nvairob2/rc_tracked_vehicle/doc/DIALOG.md

# История диалога и инженерный журнал

Проект: гусеничная платформа 10 кг (`rc_tracked_vehicle`)  
Участники: владелец проекта + AI-ассистент (Cursor / Composer)  
Формат: общий контекст для работы с разных устройств.

---

## 2026-07-24 — Сессия 1: аудит схемы, прошивок, коррекции скорости, R_IS/L_IS

### Запрос пользователя

Платформа на отладочном стенде вверх тормашками, электроника на breadboard.

- Питание моторов: 3S LiPo  
- Питание логики: UBEC 8А (12А)  
- Драйверы: BTS7960B по одному на мотор  
- Контроллер моторов: STM32F411CEU6 Black Pill  
- Общий контроллер: ESP32-S3-N16R8  

Задачи:

1. Изучить `doc/` и `schema/`
2. Изучить прошивки STM32 и ESP32
3. Разобрать корректность коррекции скорости по бортам
4. Задействовать `R_IS` / `L_IS`
5. Позже: перенос коммутации с breadboard на макетку 60×80 мм (22×27 отверстий, шаг 2.54)
6. Вести весь диалог в Markdown

---

### 1. Что есть в репозитории

| Путь | Содержание |
| :--- | :--- |
| `schema/commutation.md` | Актуальная (по факту кода) карта ESP32↔STM32 UART и ШИМ→BTS7960 |
| `schema/wire_connections.md` | Желаемая карта с аппаратными энкодерами TIM4/TIM5 — **конфликтует** с UART на PB6/PB7 |
| `sources/ESP32/vehicle_controller/` | Wi-Fi AP + веб-пульт → UART `Move,Turn\n` |
| `sources/STM32/motor_controller/` | Боевая прошивка: **open-loop**, без энкодеров |
| `sources/STM32/test_2_motors_rotation/` | Тест с «автопилотом» синхронизации бортов |
| `sources/STM32/test_1_motor_rotation/` | Аппаратный энкодер TIM5 на PA0/PA1 |
| `doc/10KG Tank chassisTutorial/` | Моторы JGB37-520, pinout энкодера, PDF параметров шасси |
| `doc/DOC028417869.pdf` | Крупный PDF (в основном сканы/картинки) |

Моторы: JGB37-520, Hall AB-энкодер, магнитный диск **11 линий**, питание энкодера 3.3–5 В, разъём PH2.0-6PIN.

Порядок проводов шлейфа (из `Motor wire.jpg` / docs):

1. M+  
2. VCC энкодера  
3. Encoder A  
4. Encoder B  
5. GND энкодера  
6. M−  

---

### 2. Архитектура (как сейчас работает)

```text
Телефон (браузер)
    │ Wi-Fi AP HeavyTank_10KG
    ▼
ESP32-S3  ──UART 115200──►  STM32F411  ──PWM 2 kHz──►  BTS7960B ×2  ──►  моторы
 GPIO43 TX → PB7 RX
 GPIO44 RX ← PB6 TX
```

Формула дифференциала (в `motor_controller.ino`):

```text
PWM_left  = move + turn
PWM_right = move - turn
```

Это классический tank-drive / arcade-drive. Само по себе верно.

---

### 3. Конфликт документации по пинам (важно!)

| Сигнал | `commutation.md` + `motor_controller` / `test_2` | `wire_connections.md` |
| :--- | :--- | :--- |
| RPWM_1 / LPWM_1 | PA7 / PA6 | PA6 / PA7 (свап) |
| RPWM_2 / LPWM_2 | PA15 / PB3 | PA8 / PA9 |
| Энкодер 1 | PB0/PB1 (`test_2`) или PA0/PA1 (`test_1`) | PA0/PA1 (TIM5) |
| Энкодер 2 | PB12/PB13 (`test_2`) | **PB6/PB7 (TIM4)** |
| UART STM32 | **PB6 TX / PB7 RX** | — |

**Вывод:** `wire_connections.md` нельзя считать истиной «как подключено сейчас». Для энкодера борта 2 нельзя занимать PB6/PB7, пока на них висит UART к ESP32. Нужна единая каноническая pin-map.

---

### 4. Коррекция скорости — вердикт: **текущий алгоритм некорректен**

#### 4.1. Где живёт коррекция

В боевой `motor_controller.ino` коррекции **нет** (комментарий «Без автопилота»).  
Логика синхронизации — только в `test_2_motors_rotation.ino`.

#### 4.2. Главный баг: смешение единиц измерения

```cpp
int32_t speed1 = actPos1 - lastPos1;          // тики энкодера за 20 мс
int32_t speed2 = actPos2 - lastPos2;          // тики энкодера за 20 мс

int targetSpeed1 = moveTarget + turnTarget;   // единицы ШИМ 0..255
int targetSpeed2 = moveTarget - turnTarget;   // единицы ШИМ 0..255

int32_t realDifference = speed2 - speed1;                 // тики
int32_t targetDifference = targetSpeed2 - targetSpeed1;   // ШИМ (= -2*turn)
int32_t error = realDifference - targetDifference;        // ❌ тики − ШИМ
```

При езде прямо (`turn = 0`) `targetDifference = 0`, и ошибка сводится к `speed2 - speed1` — это ещё осмысленно.

При повороте (`turn ≠ 0`) в ошибку подмешивается смещение порядка **сотен единиц ШИМ**, тогда как реальная разница скоростей в тиках обычно **десятки**. Интегратор `currentPWM_1` набирает ложный увод даже при правильном соотношении скоростей.

Численный пример (`move=150`, `turn=60`):

- целевые ШИМ: 210 и 90 → `targetDifference = -120`
- фактические скорости, пропорциональные цели: `speed1=42`, `speed2=18` → `realDifference = -24`
- `error = -24 - (-120) = +96` → каждый цикл +4.8 к ШИМ борта 1 → разгон интегратора

#### 4.3. Другие проблемы того же блока

1. **Асимметрия:** борт 2 всегда open-loop (`finalPWM_2 = targetSpeed2`), корректируется только борт 1. Допустимо как master/slave, но только при правильной ошибке в одних единицах.
2. **Знаки энкодеров на зеркальных моторах:** оба ISR одинаковые. Если при «вперёд» один борт даёт `+`, другой `−`, при `turn=0` ошибка огромна.
3. **Нет anti-windup** у `currentPWM_1` (есть только `constrain` на итоговом ШИМ).
4. **Программный ISR на одном канале A (CHANGE)** вместо аппаратного Encoder Mode (как в `test_1`) — хуже по джиттеру и нагрузке на CPU; для сравнения бортов ещё терпимо, но не оптимально.
5. **Нет калибровки «ШИМ → ожидаемые тики/период»** — нельзя сравнивать setpoint в ШИМ с измерением в тиках без шкалы.

#### 4.4. Что правильно делать вместо этого

**Вариант A (рекомендуемый): независимый speed-loop на каждый борт**

1. Задать целевые скорости в тиках/дТ:  
   `targetTicks1 = scale * (move + turn)`  
   `targetTicks2 = scale * (move - turn)`  
   (`scale` — эмпирический коэффициент тики↔ШИМ, либо таблица)
2. На каждом борту PI/PID:  
   `PWM_i += Kp*(targetTicks_i - speed_i) + Ki*∫...`
3. Знаки энкодеров выровнять константами `ENC_SIGN_1/2` (±1), один раз на стенде.

**Вариант B: sync только для прямолинейного хода**

- При `|turn| < ε`: минимизировать `speed1 - speed2` (оба в тиках).  
- При повороте: open-loop или полный вариант A.

**Вариант C (лучше долгосрочно):** аппаратные таймеры Encoder Mode для обоих бортов + отдельный UART на других пинах (не PB6/PB7, если они заняты энкодером).

#### 4.5. Нюанс стенда

Платформа вверх тормашками → нет одинаковой нагрузки гусениц о грунт. Разница скоростей на стенде ≠ поведение на полу. Тесты sync лучше подтверждать на земле / с одинаковой нагрузкой.

---

### 5. R_IS / L_IS — что это и как задействовать

Пользователь прав по сути: это **датчик тока** (current sense / diagnosis), а не отдельный «датчик нагрузки». Нагрузка оценивается **косвенно** через ток мотора.

По datasheet Infineon BTS7960:

- Пин `IS` отдаёт ток `IIS ≈ IL / kILIS`, где `kILIS ≈ 8500` (типично)
- На модулях IBT-2 / BTS7960B обычно уже стоят резисторы `RIS` (часто ~1–10 кΩ) на `R_IS` и `L_IS`
- `VIS = IIS × RIS = (IL / 8500) × RIS`
- В аварии (overtemp / short / current limit) пин уходит в режим fault и выдаёт повышенный ток `IIS(lim)` → напряжение резко растёт — можно детектить аварию

Важно:

- Ток измеряется через **активный high-side** ключ. При реверсе/другой половине моста «живой» другой `IS`.
- Практичный хак на многих IBT-2: **замкнуть R_IS и L_IS вместе** на один вход АЦП (если резисторы на плате уже к GND) — получать ток активного плеча на одном канале.
- Либо читать оба АЦП и брать `max(R_IS, L_IS)` / выбирать по направлению ШИМ.

Рекомендация для STM32F411 (АЦП до 3.3 В):

| Параметр | Значение |
| :--- | :--- |
| Пины (предложение) | `PA4` (борт1 IS), `PA5` (борт2 IS) — свободные ADC |
| Схема | проверить `RIS` на модуле мультиметром; при необходимости параллель для снижения Vis; делитель/стабилитрон 3.3 В для защиты АЦП |
| Частота опроса | 100–500 Гц с усреднением (ШИМ 2 кГц даёт шум) |
| Применение | ограничение тока / soft-fault, оценка нагрузки, диагностика заедания гусеницы |

Формула (после калибровки):

```text
IL ≈ (VIS / RIS_effective) * 8500
```

Калибровку лучше сделать амперметром на 1–2 известных токах — `kILIS` и реальный `RIS` на клонах плат гуляют.

---

### 6. Перенос на макетку 60×80 (22×27) — статус

Отложено до фикса pin-map и решения по энкодерам + IS.  
Цель следующей итерации: фиксированная топология разъёмов (STM32 / ESP32 / 2×BTS7960 / силовая шина / сигнал), чтобы не перепаивать проводники при переносе со стенда на шасси.

---

### 7. Решения / следующие шаги (согласовать)

- [ ] Зафиксировать **каноническую** таблицу пинов (обновить `wire_connections.md`, чтобы не противоречила UART)
- [ ] Вернуть энкодеры в `motor_controller` с правильным speed-loop (вариант A)
- [ ] Выровнять знаки энкодеров на стенде
- [ ] Подключить IS → ADC, защитить 3.3 В, добавить телеметрию тока в Serial/UART обратно на ESP32
- [ ] Спроектировать раскладку макетки 60×80

---

### Ответ ассистента (кратко)

Субъективное ощущение «коррекция сделана неправильно» — **подтверждается по коду** `test_2_motors_rotation.ino`: ошибка смешивает тики энкодера и единицы ШИМ; при поворотах интегратор уводит борт 1. Боевая прошивка коррекцию вообще отключила. `R_IS`/`L_IS` — токовые диагнозы high-side MOSFET, их нужно вести на АЦП (с учётом `RIS` и защиты 3.3 В).

---

## 2026-07-24 — Сессия 2: исправление коррекции скорости (п.4)

### Уточнение пользователя
- Игнорировать `sources/STM32/test_*` — только пробные прошивки.
- Рабочие файлы: `motor_controller.ino` (STM32) и `vehicle_controller.ino` (ESP32).
- Идти по задачам поэтапно; сейчас — исправить коррекцию скорости.

### Что сделано
1. В `motor_controller.ino` добавлен закрытый контур скорости:
   - аппаратные энкодеры TIM5 (`PA0/PA1`) и TIM1 (`PA8/PA9`) — без конфликта с UART на `PB6/PB7`;
   - период контура 20 мс;
   - на каждый борт: feedforward `cmd` + PI по ошибке в **тиках**;
   - anti-windup интеграла, deadzone, сброс при стопе.
2. Обновлены `schema/commutation.md` и `schema/wire_connections.md` под каноническую pin-map.
3. `vehicle_controller.ino` не менялся: команды `Move,Turn` те же, коррекция на стороне STM32.

### Калибровка на стенде
1. Подключить энкодеры по новой схеме (A/B/VCC/GND).
2. Прошить STM32, открыть Serial 115200.
3. Команда прямо `150,0`: смотреть `spd1`/`spd2`.
4. Если знаки разные при «вперёд» — инвертировать `ENC_SIGN_1` или `ENC_SIGN_2`.
5. Выставить `CMD_TO_TICKS ≈ |spd| / 150` (среднее по бортам).
6. При необходимости подкрутить `Kp` / `Ki`.

### Следующий этап по плану
Подключение `R_IS` / `L_IS` на АЦП (`PA4`/`PA5` зарезервированы в схеме).

---

## 2026-07-24 — Сессия 3: откат поломки команд веб-пульта

### Симптом
После добавления speed-loop ни одна команда веб-интерфейса не работает ожидаемо (раньше open-loop работал).

### Вероятные причины
1. `HardwareTimer` в `TIM_ENCODERMODE_TI12` на TIM1/TIM5 — нестандартный для Arduino API режим, риск конфликта с подсистемой `analogWrite`/таймерами.
2. PI без калибровки и/или без сигналов энкодера мог сильно уводить ШИМ от команды.

### Исправление
- Базовый ШИМ снова = `move±turn` (как в рабочей версии).
- Энкодеры через EXTI (`attachInterrupt` на A, чтение B), без захвата TIM1/TIM5 под Encoder Mode.
- Закрытый контур — только **ограниченный trim** (±40 ШИМ); при «молчании» энкодера trim = 0.
- Пины энкодеров те же: борт1 `PA0/PA1`, борт2 `PA8/PA9`.

### Проверка
1. Прошить STM32.
2. Команды FORWARD/LEFT/RIGHT/REVERSE/STOP должны снова совпадать с прежним поведением.
3. В Serial смотреть `spd=` — если нули при вращении, проверить проводку энкодеров; пока spd=0, поведение = open-loop.

---

## 2026-07-24 — Сессия 4: диагностика энкодеров по логам

### Факт
Команды веб-пульта снова корректны (`pwm == cmd`).

### Логи FORWARD/REVERSE/LEFT/RIGHT
`spd` почти всегда `0` или `±1` при `|cmd|=150…200`. Это **не** скорость вращения мотора, а шум/отсутствие импульсов на линиях энкодера.

Ожидание при живом Hall-энкодере JGB37-520 на cmd=150: `|spd|` порядка **десятков** тиков за 20 мс.

Закрытый контур из‑за `MIN_TICKS_FOR_LOOP` не включается — поэтому trim=0 и поведение = open-loop (правильно как fallback).

### Вывод
Энкодеры на `PA0/PA1` и `PA8/PA9` фактически не читаются (не подключены / нет VCC·GND / перепутаны сигнальные жилы / не те пины на breadboard).

### Действие
В лог добавлен `tot=` (накопленные тики). Чеклист проводки — в ответе пользователю.

---

## 2026-07-24 — Сессия 5: tot не накапливается при «правильной» коммутации

### Симптом
Пользователь проверил проводку; FORWARD даёт `tot≈0…1`, не растёт. Моторы крутятся (`pwm=150`).

### Интерпретация
На пинах энкодера нет устойчивого квадратурного сигнала (или он не доходит до EXTI). ±1 — шум подтяжки.

### Возможные причины
1. Неверная распиновка шлейфа (в docs конфликт: Motor wire.jpg = M+,VCC,A,B,GND,M− vs таблица docx = GND,C1,C2,VCC,M1,M2).
2. Нет питания энкодера / нет общей земли.
3. Сигналы на других жилах, чем A/B в схеме.

### Действие
Диагностическая прошивка: ISR на A **и** B, квадратурная таблица, `poll` (5 мс software edge count), `lvl`, `isr` счётчики. По логу FORWARD отличим «нет сигнала на пине» vs «EXTI не работает».

---

## 2026-07-24 — Сессия 6: энкодеры живы, калибровка знаков

### Лог FORWARD (диагностика)
- `poll`/`isr`/`tot` растут → сигнал на пинах есть, EXTI работает.
- При `cmd=+150,+150`: `spd1≈−64`, `spd2≈+46` — **противоположные знаки** (зеркальный борт).
- Из‑за этого PI уводил ШИМ (`pwm≈183,144` вместо ~150,150).

### Правки
- `ENC_SIGN_1 = -1`, `ENC_SIGN_2 = +1`
- `CMD_TO_TICKS = 0.37` (среднее |spd|/150)
- Убран poll из цикла управления (давал +10 мс задержки на период)
- Лог снова компактный: cmd/spd/tot/pwm

### Ожидание после прошивки (FORWARD)
- `spd1` и `spd2` оба **положительные**
- `tot` обоих растёт вверх
- `pwm` около 150, с небольшим trim (борт2 чуть быстрее/медленнее догоняет по тикам)

---

## 2026-07-24 — Сессия 7: подтверждение калибровки знаков

### FORWARD
- `spd` оба >0, `tot` растёт, борта почти симметричны (~50/49).
- `pwm` стабилизируется ~151/152 — контур работает.

### REVERSE
- `spd` оба <0, `tot` убывает, симметрия ~−48/−49, `pwm` ~−152.

### Вердикт
П.4 (коррекция скорости) практически закрыт: знаки верные, измерение и trim адекватны.
Уточнён `CMD_TO_TICKS = 0.333` под установившиеся ~50 тиков/@150.

### Следующий этап
R_IS / L_IS (ток драйверов) или проверка LEFT/RIGHT на стенде.

---

## 2026-07-25 — Сессия 8: комментарии + пункт 5 (R_IS / L_IS)

### Запрос
Добавить поясняющие комментарии на русском; приступить к измерению тока через IS.

### Сделано
1. `motor_controller.ino` — русские комментарии по блокам (пины, скорость, ток, UART).
2. Ток:
   - `PA4` / `PA5` — АЦП 12 бит;
   - на каждый драйвер: `R_IS`+`L_IS` вместе на один вход;
   - `IL ≈ (VIS/RIS)×8500`, старт `RIS_OHMS=1000`;
   - EMA + усреднение выборок;
   - мягкий лимит 3.5 А / жёсткий 5.0 А;
   - в логе поле `I=i1,i2`, на стопе `STOP I=...`.
3. Обновлены `schema/commutation.md`, `schema/wire_connections.md`.

### Проверка на стенде
1. Замкнуть R_IS–L_IS на каждом BTS7960B, соединить с PA4/PA5, общая GND.
2. Желательно защита 3.3 В на линии IS.
3. STOP: `I≈0` (шум нуля).
4. FORWARD без нагрузки: ток доли ампера; при удерживании вала — рост к stall.
5. При завышении/занижении ампер — калибровать `RIS_OHMS` по амперметру.

---

## 2026-07-25 — Сессия 9: проверка тока под нагрузкой

### Логи
- Без нагрузки: `I≈0.09,0.30`, `spd≈52/52`, trim ок.
- Нагрузка слева: `I≈1.14` слева, справа ~0.3; `spd` 22 vs 51 → PWM слева ↑ до 157.
- Нагрузка справа: `I` справа растёт 2.4→3.0 А; `spd` падает; PWM справа ↑ до 161.

### Вердикт
IS работает качественно (нагрузка на борту → рост тока этого борта). Контур скорости поднимает ШИМ отстающему борту.

Асимметрия холостого нуля 0.09 vs 0.30 и разный ток при «ручной» нагрузке (1.1 vs ~3 А) — разный оффсет/сила торможения и/или калибровка каналов. Абсолютная точность без амперметра не подтверждена.

### Правка
`I_OFFSET_1_A=0.09`, `I_OFFSET_2_A=0.30` — вычитание нуля по холостому FORWARD.

---

## 2026-07-25 — Сессия 10: ток после оффсетов

### Лог
- FORWARD: `I≈0.08–0.12` оба борта, `spd`/`pwm` в норме.
- STOP: EMA сходит с ~0.1 к ~0.08/0.04.

### Вывод
Каналы сбалансированы. Остаток на ходу ≈ ток холостого хода; на стопе — пол АЦП/утечки.
Оффсеты переведены на базу STOP: `0.08` / `0.04`. П.5 считаем принятым.

---

## 2026-07-25 — Сессия 11: STOP I≠0 и разбор readMotorCurrentA

### Симптом
После оффсетов 0.08/0.04 на STOP стабильно `I=0.12,0.15`.

### Причина
Оффсеты взяли из уже вычтенного лога STOP, а не из сырого тока. Исправление: `I_OFFSET = 0.20 / 0.19`.

### Пояснение пользователю
`RIS_OHMS < 1` — guard от деления на ноль; логичнее в начале функции (перенесено).

---

## 2026-07-25 — Сессия 12: коммит + старт п.6 (макетка)

### Коммит
`b5513f6` — Add encoder speed trim and BTS7960 current sense on STM32  
(ветка `feature/breadbord-with-soldering`).

### П.6
Документ `schema/protoboard_60x80.md`:
- плата **60×80 мм**, сетка 22×27, шаг 2.54;
- ESP32 остаётся на Expansion Board с клеммами — на макетку не сажаем;
- на макетке: Black Pill + клеммы питания/UART/драйверов/энкодеров;
- сила моторов и модули BTS7960 — вне платы.

---

## 2026-07-25 — Сессия 13: разъёмы из наличия

### Инвентарь пользователя
Dupont 2.54, JST PH 2.0, JST XH 2.54, JST 2P, PBS-40/20, AWG 10–24, ПОС-61, NC-559, паяльник.

### Решение по дизайну
- На макетке (шаг 2.54): **XH** и Dupont/PBS.
- **PH 2.0** не сажать на плату (шаг 2.0) — только адаптер мотор PH → XH-4.
- J_DRV = XH-6; J_ENC = XH-4; сила 10–16 AWG вне платы.
- Обновлён `schema/protoboard_60x80.md` + BOM из наличия.

---

## 2026-07-25 — Сессия 14: стойки М3 и level shifter

### Наличие
- Стойки М3 30–50 мм → на макетку предпочтительно 30–35 мм.
- Преобразователи 5V↔3.3V → для текущей схемы не обязательны (UART 3.3↔3.3; энкодер лучше питать 3.3 V; IS — стабилитрон, не shifter).

---

## 2026-07-25 — Сессия 15: координаты платы и крепёж Ø2

### Уточнения пользователя
- Крепёж Ø2 мм; можно рассверлить под М3.
- Столбцы A…V слева направо; строки 1…27 **сверху вниз**.

### Правки в protoboard_60x80.md
- Координаты переведены на A–V / 1–27.
- Рекомендация: рассверлить углы до ~3.1 мм под М3.
- Черновые позиции J_PWR, J_UART, MCU, J_DRV, J_ENC на сетке.

---

## 2026-07-25 — Сессия 16: краевые лужёные шины B…U

### Уточнение
Над стр.1 и под стр.27 — сплошные лужёные площадки столбцов B…U.

### Решение
Использовать как шины питания: верх = 5V, низ = GND (подписать). Обновлён protoboard_60x80.md.

---

## 2026-07-25 — Сессия 17: краевые площадки изолированы

### Прозвонка пользователя
Площадки B…U над/под платой не соединены между собой — каждая изолирована.

### Правка
Это не готовая шина. Варианты: игнорировать или спаять мосты B–U в шину 5V/GND вручную. Документ обновлён.

---

## 2026-07-25 — Сессия 18: адреса пинов Black Pill на макетке

### Уточнение пользователя
10 пинов с стороны, ширина 7 inclusive.

### Факт
WeAct F411 — **20×2** пинов; ширина 7 отверстий верна.

### Решение
Посадка: столбцы **H** и **N**, строки **4…23**, USB вверх.
Полная таблица адресов и карта используемых сигналов — в `schema/protoboard_60x80.md` §3.1.
Пинout-картинка: `doc/blackpill_f411_pinout.png`.

---

## 2026-07-27 — Сессия 19: координаты J_DRV XH-8

### Запрос
Точная разметка JST XH-8 для связи макетки с 8-pin логикой BTS7960.

### Решение (schema/protoboard_60x80.md §3.2)
- **J_DRV1** (борт 1): **B25…I25**, ключ к строке 27, пин 1 = B25 (GND).
- **J_DRV2** (борт 2): **O25…V25**, пин 1 = O25 (GND).
- Порядок 1–8 = GND, VCC, RPWM, LPWM, R_EN, L_EN, R_IS, L_IS (IBT-2).
- На плате: мосты 5–6 и 7–8; отводы к N11/N12/N16/N14 и H13/H14/N15/N13.

---

## 2026-07-27 — Сессия 20: J_DRV строка 26, края платы

### Замечание
Строка 25 слишком близко к STM32; вопрос про ориентацию XH и неиспользование краёв.

### Решение
- J_DRV перенесены на **строку 26**; строка **25** — буфер под проводку.
- Ориентация: по умолчанию ключ к **27** (жгут вниз); альтернатива — ключ к **1**.
- §2.1: края A/V и строки 1/27 — не «запрет», а крепёж/USB; **A=GND, V=5V** рекомендованы.

---

## 2026-07-27 — Сессия 21: MCU +1 вверх

### Сделано
Black Pill перенесён на **1 строку вверх**: столбцы **H…N**, строки **3…22** (было 4…23). Обновлены адреса пинов MCU и отводов J_DRV в `schema/protoboard_60x80.md`.

---

## 2026-07-27 — Сессия 22: строка 27 и корпус XH

### Уточнения
1. **Строка 27 не нужна** для разводки — J_DRV на **26**, корпус XH перекрывает 27, это нормально.
2. Корпус **JST XH асимметричен** (толстая сторона без прорезей) — переворот ключа не «освобождает» нижний ряд; бороться с этим не требуется.
