nvairob2/rc_tracked_vehicle/schema/commutation.md

# 🤖 Схема коммутации гусеничного шасси «Танк 10 кг»

Данная схема фиксирует текущее бесконфликтное состояние электроники, обеспечивающее мгновенный отклик моторов по Wi-Fi через неблокирующий посимвольный UART-мост.

## 🎛️ Архитектура системы и распределение задач

1. **ESP32-S3 (N16R8) на Expansion Board:** Выступает в роли «мозга-приемника». Поднимает Wi-Fi точку доступа `HeavyTank_10KG`, крутит веб-сервер и транслирует команды в виде ASCII-строк `Move,Turn\n`.
2. **STM32F411CEU6 (BlackPill):** Выступает в роли силового исполнительного контроллера ходовой части. Принимает поток данных по UART, парсит его на лету и генерирует ШИМ высокой частоты (2 кГц) для драйверов.
3. **BTS7960B (2 шт.):** Мощные силовые H-мосты, питающие коллекторные редукторные двигатели JGB37-520 от силового аккумулятора 3S Li-Po (12.4V).

---

## 🔌 Сводная таблица соединений (Wire Map)

### 1. Межплатный мост связи (ESP32-S3 ➔ STM32)
*Используются нативные физические выводы аппаратного UART-интерфейса в перекрестном режиме.*

| Вывод на Expansion Board ESP32-S3 | Вывод на плате BlackPill STM32 | Функция линии |
| :--- | :--- | :--- |
| **GND** | **GND** | **Общая логическая земля (Обязательно!)** |
| **TX** *(Физический маркер, GPIO43)* | **PB7** *(Вход RX1)* | Передача команд управления от ESP32 к STM32 |
| **RX** *(Физический маркер, GPIO44)* | **PB6** *(Вход TX1)* | Обратная связь (зарезервировано на будущее) |

---

### 2. Силовая часть и моторы (Драйверы ➔ Двигатели)
*Провода шлейфа моторов JGB37-520 подключены по зеркальной схеме «через один», вычисленной фабричной документацией.*

#### Борт 1 (Левый)
* **Провод 1 шлейфа мотора (M+)** ➔ Силовая клемма **M+ (OUT1)** Драйвера 1
* **Провод 6 шлейфа мотора (M-)** ➔ Силовая клемма **M- (OUT2)** Драйвера 1
* **Провод 2 (VCC энкодера)** ➔ **5V** BlackPill
* **Провод 3 (Encoder A)** ➔ **PA0** (EXTI)
* **Провод 4 (Encoder B)** ➔ **PA1** (GPIO)
* **Провод 5 (GND энкодера)** ➔ **GND** BlackPill

#### Борт 2 (Правый)
* **Провод 1 шлейфа мотора (M+)** ➔ Силовая клемма **M+ (OUT1)** Драйвера 2
* **Провод 6 шлейфа мотора (M-)** ➔ Силовая клемма **M- (OUT2)** Драйвера 2
* **Провод 2 (VCC энкодера)** ➔ **5V** BlackPill
* **Провод 3 (Encoder A)** ➔ **PA8** (EXTI)
* **Провод 4 (Encoder B)** ➔ **PA9** (GPIO)
* **Провод 5 (GND энкодера)** ➔ **GND** BlackPill

---

### 3. Логическое управление мостами (STM32 ➔ Драйверы BTS7960B)
*Частота ШИМ зафиксирована программно на уровне **2000 Гц** для исключения слышимого писка обмоток и обеспечения максимального крутящего момента.*

| Сигнал на логической колодке драйвера | Куда идет от Драйвера 1 (Борт 1) | Куда идет от Драйвера 2 (Борт 2) | Описание задачи пина |
| :--- | :--- | :--- | :--- |
| **VCC** | **5V** на STM32 | **5V** на STM32 | Питание логики логических затворов моста |
| **GND** | **GND** на STM32 | **GND** на STM32 | Общий минус сигнальных линий |
| **R_EN** + **L_EN** *(замкнуты вместе)* | Пин **PA2** STM32 | Пин **PA3** STM32 | Сигнал активации (Sleep/Wake) драйвера |
| **RPWM** | Пин **PA7** STM32 | Пин **PA15** STM32 | ШИМ-сигнал направления «Вперед» |
| **LPWM** | Пин **PA6** STM32 | Пин **PB3** STM32 | ШИМ-сигнал направления «Назад» |
| **R_IS + L_IS** *(замкнуты вместе)* | Пин **PA4** STM32 (ADC) | Пин **PA5** STM32 (ADC) | Ток нагрузки / diagnosis high-side |

> На модулях IBT-2 обычно уже есть `RIS` к GND. Замкнуть `R_IS` и `L_IS` перемычкой и одним проводом вести на АЦП. Общая GND с STM32 обязательна. АЦП ≤ 3.3 В — желателен делитель или стабилитрон 3.3 В (в fault IS может дать несколько вольт).

---

### 4. Линии питания (Шины Power 12V / 5V)
* **Силовая батарея 3S Li-Po (12.4V):** Подключена параллельно к клеммам **B+** и **B-** обоих драйверов BTS7960B.
* **Логическое питание 5V:** От UBEC (или временно USB BlackPill). Шина **5V** питает логику драйверов и VCC энкодеров. ESP32 — со своего питания / той же 5V шины по факту стенда.
* **Провод 3V3 программатора ST-Link:** Полностью **отключен** во избежание встречного тока стабилизаторов.

---

### 5. Контур скорости (прошивка `motor_controller`)
* Базовый ШИМ (как open-loop): `cmd1 = move+turn`, `cmd2 = move-turn`.
* Измерение: EXTI на обеих фазах энкодера; скорость в **тиках / 20 мс**.
* Коррекция: ограниченный trim (±40 ШИМ) от PI по ошибке в тиках; при отсутствии импульсов энкодера trim = 0 → поведение как open-loop.
* Калибровка `CMD_TO_TICKS` и знаков `ENC_SIGN_1/2` — по Serial-логу `spd=`.

### 6. Ток драйверов (`R_IS` / `L_IS`)
* На каждый BTS7960B: `R_IS` и `L_IS` замкнуты → `PA4` (борт 1) / `PA5` (борт 2).
* Формула: `IL ≈ (VIS / RIS) × 8500`. Стартовый `RIS_OHMS = 1000` — уточнить на модуле и калибровать амперметром.
* В логе: `I=i1,i2` (амперы). Мягкий лимит 3.5 А, жёсткий стоп 5.0 А (`CURRENT_LIMIT_ENABLE`).
