nvairob2/rc_tracked_vehicle/schema/protoboard_60x80.md

# Макетка 60×80 мм — дизайн коммутации (п.6)

> Размер: **60×80 мм** (не см), сетка **22×27** отверстий, шаг **2.54 мм**.  
> Цель: перенести сигнальную обвязку со стендового breadboard на паяную плату, не трогая силовые цепи драйверов.

## 1. Что на этой плате, а что нет

| На макетке 60×80 | Вне платы (как сейчас) |
| :--- | :--- |
| STM32 Black Pill (F411) на штырях PBS | ESP32-S3 на **своей Expansion Board** с клеммами |
| Разъёмы логики к 2× BTS7960 (XH / Dupont) | Сами модули BTS7960 (силовые B+/B−, M+/M−) |
| Разъёмы энкодеров (на плате XH 2.54) | Силовая 3S LiPo |
| Ввод 5V/GND от UBEC (JST 2P / XH-2) | UBEC (крепление рядом) |
| UART TX/RX/GND → ESP expansion (XH-3 / Dupont) | Wi‑Fi / веб-пульт |
| Опционально: защита IS (стабилитрон 3.3 В) | Адаптер PH2.0 мотора → XH на плате |

**Принцип:** по макетке идут только логика и 5V. Токи моторов — только по толстым силовым проводам драйверов (10–16 AWG), не через отверстия платы.

---

## 2. Система координат (как на твоей плате)

Вид **сверху** (компоненты к себе):

| Ось | Обозначение на плате | Направление |
| :--- | :--- | :--- |
| Столбцы | буквы **A … V** (22 шт.) | слева → направо |
| Строки | числа **1 … 27** | **сверху → вниз** |

Адрес отверстия: например **`D12`** = столбец D, строка 12.

Крайние отверстия у крепежа лучше не занимать **компонентами** (корпуса разъёмов, PBS): рабочие поля — **B…U**, строки **2…26**. Подробнее — §2.1.

### 2.1. Крайние строки и столбцы — зачем «берегли» и что можно занять

| Зона | Что там физически | Почему изначально не трогали | Что **можно** использовать |
| :--- | :--- | :--- | :--- |
| **A1, V1, A27, V27** | крепёж Ø2→3 мм | винт/стойка, нельзя паять | только стойка М3 |
| **Строка 1** | крепёж + изолированные площадки B…U | верх занят USB MCU, J_PWR | площадки как **точки отвода** 5V; не ставить высокие разъёмы над USB |
| **Строка 27** | крепёж + изолированные площадки B…U | корпус XH с **26** перекрывает ряд | **не нужна** для разводки; **A27/V27** — стойки |
| **Столбец A** | край + угол = крепёж | привычка «поля от края» | **шина GND** по всей длине (удобно!) |
| **Столбец V** | край + угол = крепёж | то же | **шина 5V** или жгуты к правому краю |
| **Строки 2, 26** | обычные отверстия | — | разъёмы, перемычки |
| **Строка 24–25** | между MCU и низом | **буфер** под проводку | J_ENC, сервисная разводка |

**Итог:** **A = GND, V = 5V**, **J_DRV** на **строке 26** — нормальное использование края. Строка **27** сознательно отдана под корпус XH; на плате места хватает.

### Лужёные площадки B…U над строкой 1 и под строкой 27

На плате есть ряд площадок **B…U** выше строки 1 и ниже строки 27.

**Факт (прозвонка):** площадки **изолированы** друг от друга — ни в одном ряду, ни между рядами гальванической связи нет. Это не готовая шина питания, а отдельные контактные пятна (удобно паять отвод/перемычку).

Как использовать:

| Вариант | Что делать |
| :--- | :--- |
| **A. Не использовать** | Игнорировать; 5V/GND вести обычным проводом (столбцы/перемычки) |
| **B. Сделать шину самому** | Соединить соседние площадки **каплями припоя** или голой перемычкой B–U: верхний ряд → **5V**, нижний → **GND** (подписать!). Перед этим ещё раз прозвонить, что мосты сели только внутри одного ряда |

Рекомендация: вариант **B** удобен (получится та самая краевая шина), если аккуратно пропаять мосты; иначе вариант A ничем не хуже.

### Крепёжные отверстия Ø2 мм

Возражений против рассверловки **до Ø3.0–3.2 мм** нет — под стойки **М3** так и нужно.

| Вариант | Когда |
| :--- | :--- |
| **Рассверлить до ~3.1 мм** | Есть стойки М3 (твой случай) — предпочтительно |
| Оставить 2 мм + винты **М2** | Если найдутся стойки/винты М2 |
| Не сверлить, крепить за край | Худший вариант (люфт) |

При сверлении: сверло 3.0–3.2 мм, подложить дерево, не давить — у углов обычно нет дорожек. Зачистить заусенцы, чтобы не замыкали соседние отверстия.

---

## 3. Зоны платы (вид сверху, строки 1→27 вниз)

```text
     A  B  C        ...           T  U  V
  1  ●  площадки B…U (изолированы)                 ●
  2     J_PWR / J_UART (к N3/N4, H16/H17)
  3              H═══════════════N     ← MCU pin 1 (USB вверх)
  4              ║  BLACK PILL   ║
 ...             ║  F411 20×2    ║       столбцы H и N
 16              ║  PB6······PA1 ║
 17              ║  PB7······PA0 ║
 22              H═══════════════N     ← MCU pin 20
 23     · · · буфер · · ·
 24     J_ENC1 (XH-4)              J_ENC2 (XH-4)
 25     · · · буфер / коридор проводки · · ·
 26     J_DRV1 XH-8                J_DRV2 XH-8
 27 ●  (корпус XH — не используем)                  ●
```

**Black Pill:** строки **3…22**, столбцы **H…N** (сдвинут на 1 строку вверх). **J_DRV** — **строка 26**.

### Предварительные координаты разъёмов (ключ корпуса «к краю платы»)

| Разъём | Зона (примерно) | Примечание |
| :--- | :--- | :--- |
| **Black Pill** | столбцы **H** и **N**, строки **3…22** | см. §3.1 |
| **J_PWR** | `B2–C2` → **N3** / **N4** | 5V / GND MCU |
| **J_UART** | `B2–D2` или у **H16–H17** | PB6 / PB7 |
| **J_DRV1** | **B26…I26** (XH-8) | §3.2 |
| **J_DRV2** | **O26…V26** (XH-8) | §3.2 |
| **J_ENC1** | `B24–E24` | PA0/PA1 → **N17** / **N16** |
| **J_ENC2** | `P7–U7` | PA8/PA9 → **H7** / **H8** |
| Крепёж Ø3 | углы платы | рассверлить |

---

## 3.1. Black Pill на сетке макетки — адреса пинов

### Важно про число пинов

Стандартный **WeAct Black Pill STM32F411CEU6** — это **20 пинов × 2 ряда** (40 выводов), не 10+10.  
Ширина «от штыря до штыря **включительно**» = **7** отверстий макетки — верно (шаг рядов 0.6″).

Ориентация на макетке (вид сверху, компоненты к себе):

- USB-C платы MCU → к **верху** макетки (к строке 1)  
- Левый ряд MCU (шелкография **PB12…3V3**) → столбец **H**  
- Правый ряд MCU (шелкография **5V…VBAT**) → столбец **N**  
- Столбцы между рядами: `H I J K L M N` = 7 Inclusive  

Строка макетки для k-го штыря сверху: **`row = 2 + k`** (первый штырь на строке **3**, двадцатый на строке **22**).

Официальная распиновка (WeAct / Richard Balint): `doc/blackpill_f411_pinout.png`

### Полная карта: отверстие макетки → сигнал MCU

| Строка | **H** (лево MCU) | **N** (право MCU) |
| :---: | :--- | :--- |
| 3 | PB12 | **5V** |
| 4 | PB13 | **GND** |
| 5 | PB14 | 3V3 |
| 6 | PB15 | PB10 |
| 7 | **PA8** (ENC2 A) | PB2 |
| 8 | **PA9** (ENC2 B) | PB1 |
| 9 | PA10 | PB0 |
| 10 | PA11 (USB DM) | **PA7** (RPWM1) |
| 11 | PA12 (USB DP) | **PA6** (LPWM1) |
| 12 | **PA15** (RPWM2) | **PA5** (IS2) |
| 13 | **PB3** (LPWM2) | **PA4** (IS1) |
| 14 | PB4 | **PA3** (EN2) |
| 15 | PB5 † | **PA2** (EN1) |
| 16 | **PB6** (UART TX→ESP) | **PA1** (ENC1 B) |
| 17 | **PB7** (UART RX←ESP) | **PA0** (ENC1 A) † |
| 18 | PB8 | NRST |
| 19 | PB9 | PC15 |
| 20 | **5V** | PC14 |
| 21 | **GND** | PC13 (LED) |
| 22 | 3V3 | VBAT |

† На F411 выводы **PA0** и **PB5** — **не 5V-tolerant**. Энкодер борта 1 на PA0/PA1: при VCC энкодера 5 V теоретический риск для PA0. На стенде работает; долгосрочно безопаснее **3V3** или делитель. PB5 не используем.

### Только используемые сигналы проекта → адрес

| Назначение | MCU | Адрес на макетке |
| :--- | :--- | :--- |
| Питание 5V | 5V | **N3** (дубль **H20**) |
| Земля | GND | **N4** (дубль **H21**) |
| RPWM борт1 | PA7 | **N10** |
| LPWM борт1 | PA6 | **N11** |
| EN борт1 | PA2 | **N15** |
| IS борт1 | PA4 | **N13** |
| ENC1 A | PA0 | **N17** |
| ENC1 B | PA1 | **N16** |
| RPWM борт2 | PA15 | **H12** |
| LPWM борт2 | PB3 | **H13** |
| EN борт2 | PA3 | **N14** |
| IS борт2 | PA5 | **N12** |
| ENC2 A | PA8 | **H7** |
| ENC2 B | PA9 | **H8** |
| UART TX | PB6 | **H16** |
| UART RX | PB7 | **H17** |

### Схема посадки (фрагмент сетки)

```text
        H     I J K L M     N
     3  PB12  · · · · ·    5V     ← USB MCU вверх
     4  PB13  · · · · ·    GND
     7  PA8   · · · · ·    PB2    ← ENC2 A
     8  PA9   · · · · ·    PB1    ← ENC2 B
    10  PA11  · · · · ·    PA7    ← RPWM1
    12  PA15  · · · · ·    PA5    ← RPWM2 / IS2
    13  PB3   · · · · ·    PA4    ← LPWM2 / IS1
    15  PB5   · · · · ·    PA2    ← EN1
    16  PB6   · · · · ·    PA1    ← UART TX / ENC1 B
    17  PB7   · · · · ·    PA0    ← UART RX / ENC1 A
    20  5V    · · · · ·    PC14
    21  GND   · · · · ·    PC13
    22  3V3   · · · · ·    VBAT
```

Постель: PBS в столбцы **H** и **N**, строки **3–22**.

---

## 3.2. J_DRV1 / J_DRV2 — JST XH-8 (логика BTS7960B)

Один разъём **XH-8** на каждый драйвер. Порядок пинов **1…8** совпадает со штатной 8-пиновой колодкой IBT-2 / BTS7960B (слева направо, если смотреть на модуль **со стороны логических пинов**, силовые клеммы — от тебя).

> Перед пайкой жгута **сверь с шелкографией своего модуля**. Если порядок другой — переставь только жгут, координаты на макетке не меняются.

### Ориентация корпуса XH на плате

У **JST XH 2.54** корпус **асимметричен**: сторона без прорезей (с защёлкой) **толще**. Штыри — в одной строке, но пластик заходит на соседний ряд; переворот ключа только меняет, **какой** сосед перекрыт.

**J_DRV** — строка **26**. Корпус перекроет **27** (или **25**, если перевернуть) — **это не проблема**: строка 27 нам не нужна, угловые **A27/V27** остаются под стойки.

Ориентация ключа — **на выбор** при пайке (удобнее, когда жгут уходит к драйверу вниз). Пин **1** — столбец **B** (J_DRV1) или **O** (J_DRV2).

### Координаты на макетке (строка **26**)

| Пин XH | **J_DRV1** (борт 1) | Сигнал | Куда на MCU |
| :---: | :---: | :--- | :--- |
| **1** | **B26** | GND | **A** / **N4** |
| **2** | **C26** | VCC | **V** / **N3** |
| **3** | **D26** | RPWM | **N10** (PA7) |
| **4** | **E26** | LPWM | **N11** (PA6) |
| **5** | **F26** | R_EN | **N15** (PA2) |
| **6** | **G26** | L_EN | **N15** (PA2) |
| **7** | **H26** | R_IS | **N13** (PA4) |
| **8** | **I26** | L_IS | **N13** (PA4) |

| Пин XH | **J_DRV2** (борт 2) | Сигнал | Куда на MCU |
| :---: | :---: | :--- | :--- |
| **1** | **O26** | GND | **A** / **N4** |
| **2** | **P26** | VCC | **V** / **N3** |
| **3** | **Q26** | RPWM | **H12** (PA15) |
| **4** | **R26** | LPWM | **H13** (PB3) |
| **5** | **S26** | R_EN | **N14** (PA3) |
| **6** | **T26** | L_EN | **N14** (PA3) |
| **7** | **U26** | R_IS | **N12** (PA5) |
| **8** | **V26** | L_IS | **N12** (PA5) |

### Схема строк 24–27 (вид сверху)

```text
     B   C   D   E   F   G   H   I     ...     O   P   Q   R   S   T   U   V
24      J_ENC1 (XH-4)
25      · · · коридор перемычек · · ·
26  [1] [2] [3] [4] [5] [6] [7] [8]           [1] [2] [3] [4] [5] [6] [7] [8]
     └──────── J_DRV1 ──────────┘               └──────── J_DRV2 ──────────┘
27 ●  ← корпус XH (не используем)                                    ●
```

### Пайка на макетке (обязательно)

| Пара пинов XH | Что сделать на плате | Зачем |
| :--- | :--- | :--- |
| **5 + 6** | **F26–G26** (DRV1) и **S26–T26** (DRV2) | R_EN + L_EN → один EN |
| **7 + 8** | **H26–I26** (DRV1) и **U26–V26** (DRV2) | R_IS + L_IS → один ADC |
| **7** (после моста) | Стабилитрон 3.3 V у **H26** и **U26** | защита АЦП |

На **самом модуле драйвера** дополнительно замкни перемычкой **R_EN–L_EN** и **R_IS–L_IS** (как на стенде) — жгут XH-8 тогда встаёт «как есть».

### Отводы от XH к Black Pill (длина минимальная)

| От (XH) | До (MCU) | Провод |
| :--- | :--- | :--- |
| B26, O26 | **A** (GND) + **N4** | 22 AWG |
| C26, P26 | **V** (5V) + **N3** | 22 AWG |
| D26 | **N10** | 24 AWG |
| E26 | **N11** | 24 AWG |
| F26–G26 | **N15** | 24 AWG |
| H26–I26 | **N13** | 24 AWG |
| Q26 | **H12** | 24 AWG |
| R26 | **H13** | 24 AWG |
| S26–T26 | **N14** | 24 AWG |
| U26–V26 | **N12** | 24 AWG |

Проводку вести через **строки 23–25**, не над корпусом XH.

### Жгут макетка ↔ драйвер

- Разъём на плате: **XH-8 female** (припаян).  
- Разъём на драйвере: **XH-8 male** на штатную 8-пиновую колодку (или Dupont 1×8, если удобнее).  
- Длина **15–25 см**, провод **22–24 AWG**.  
- Цвета (рекомендация): чёрный GND, красный 5V, остальное разными.

```text
Макетка J_DRV1 (B26…I26)  ═══ жгут XH-8 ═══  8-pin header BTS7960 #1
Макетка J_DRV2 (O26…V26)  ═══ жгут XH-8 ═══  8-pin header BTS7960 #2
```

---

## 4. Разъёмы из имеющегося набора

### Важно про шаги

| Тип | Шаг | На макетку 2.54 |
| :--- | :---: | :--- |
| **Dupont** F/M | 2.54 | Да, напрямую |
| **JST XH** | 2.54 | Да, напрямую (предпочтительно на плате) |
| **PBS** штыревой | 2.54 | Да (колодки под MCU / перемычки) |
| **JST PH** | **2.0** | Нет как корпус на плате — только кабель/адаптер |
| **JST 2P** | уточнить PH или XH | 2P XH → на плату; 2P PH → только жгут |

Штатный разъём энкодера JGB37-520 — **PH2.0-6PIN**. Его шаг 2.0 мм не совпадает с отверстиями макетки. Поэтому:

- на **моторе** остаётся PH2.0;  
- на **макетке** ставим **XH-4** (или Dupont 1×4);  
- между ними короткий адаптерный жгут PH-6 → обрезка M+/M− в сторону драйвера, VCC/A/B/GND в XH-4.

### Назначение разъёмов

| Разъём | На плате (рекомендация) | Жгут / ответная часть | Сечение провода |
| :--- | :--- | :--- | :--- |
| **J_PWR** | JST XH-2 или JST 2P (если XH) | UBEC 5V/GND | **20–22 AWG** |
| **J_UART** | JST XH-3 или Dupont 1×3 | к клеммам ESP Expansion | **24 AWG**, витой |
| **J_DRV1/2** | JST **XH-8** ×2 | жгут XH-8 ↔ 8-pin драйвера | **22–24 AWG** |
| **J_ENC1/2** | JST XH-4 | адаптер ← PH2.0 мотора | **24 AWG** |
| Black Pill | PBS + Dupont F | — | — |
| Сила моторов / батарея | **не на макетке** | винтовые клеммы драйвера | **10–16 AWG** |

`J_DRV` — по **XH-8** на драйвер: все 8 логических пинов без обрезки.

### J_PWR — UBEC → плата (2 pin)

| Пин | Сигнал | STM32 |
| :---: | :--- | :--- |
| 1 | **5V** | 5V |
| 2 | **GND** | GND |

На жгуте UART к ESP достаточно GND+TX+RX. Общий 5V с ESP — только если питание Expansion уже от той же шины UBEC.

### J_UART — → ESP Expansion (3 pin)

| Пин | Сигнал | STM32 | ESP Expansion |
| :---: | :--- | :--- | :--- |
| 1 | GND | GND | GND |
| 2 | TX | **PB6** | RX (GPIO44) |
| 3 | RX | **PB7** | TX (GPIO43) |

Сторона ESP: в клеммы Expansion — Dupont male / зачищенный хвост. Длина жгута 10–20 см.

### J_DRV1 / J_DRV2 — см. §3.2

Полная разводка: **J_DRV1** = `B26…I26`, **J_DRV2** = `O26…V26`, порядок пинов как на 8-pin header BTS7960.

### J_ENC1 / J_ENC2 — энкодер (XH-4 на плате)

| Пин XH | Сигнал | Шлейф мотора | Борт1 | Борт2 |
| :---: | :--- | :--- | :--- | :--- |
| 1 | VCC | провод 2 | 5V | 5V |
| 2 | A | провод 3 | **PA0** | **PA8** |
| 3 | B | провод 4 | **PA1** | **PA9** |
| 4 | GND | провод 5 | GND | GND |

Провода 1 (M+) и 6 (M−) шлейфа — **только** на силовые клеммы BTS7960, сечение 16–18 AWG или штатное.

### Адаптер энкодера (2 шт.)

```text
Мотор PH2.0-6P          Адаптер                 Макетка XH-4
1 M+  ──────────────────────────► клемма M+ драйвера (силовой)
2 VCC ──┐
3 A   ──┼──► PH female / пайка ──► XH male ──► J_ENC
4 B   ──┤
5 GND ──┘
6 M-  ──────────────────────────► клемма M- драйвера (силовой)
```

---

## 5. Шины на плате (пайка)

Инструмент: паяльник с регулировкой, **ПОС-61**, флюс **NC-559-ASM** (безотмывочный — остатки можно не смывать, но крупные лужи лучше промокнуть).

Дорожки:

1. **GND** — столбец **A**, строки **2…26** (край — как раз удобно).
2. **5V** — столбец **V**, строки **2…26**.
3. Строки **23–25** — коридор перемычек MCU ↔ J_DRV / J_ENC.
4. Сигналы — **24 AWG**, не пересекать силовые жгуты моторов.

### Защита IS

У пинов **7** каждого J_DRV (после моста 7–8): стабилитрон **3.3 В** у **H26** и **U26**.

---

## 6. Крепёж и механика на машине

- Штатные крепёжные отверстия платы: **Ø2 мм** в углах.  
- Под стойки **М3**: аккуратно рассверлить до **Ø3.0–3.2 мм** (см. §2).  
- Высота стоек **30–35 мм** предпочтительнее; 40–50 мм — если мешает рама.  
- ESP Expansion — отдельно; UART — сигнальный жгут.  
- BTS7960 ближе к моторам; жгуты J_DRV короткие.

### Преобразователи логических уровней 5V↔3.3V

В текущей архитектуре **в базовой сборке не обязательны**.

| Цепь | Уровни | Нужен level shifter? |
| :--- | :--- | :--- |
| UART ESP32 ↔ STM32 | оба **3.3 V** | **Нет** |
| STM32 → BTS7960 (PWM/EN) | 3.3 V → логика драйвера (обычно принимает 3.3 V) | **Нет** (при необходимости — проверка VIH модуля) |
| Энкодер Hall → STM32 | если VCC энкодера **5 V**, выход ~5 V; пины F411 5V-tolerant | **Обычно нет**; безопаснее питать энкодер от **3.3 V** Black Pill |
| IS (ток) → АЦП | аналог, в fault может быть >3.3 V | **Не level shifter**, а стабилитрон/делитель |

Если level shifter всё же ставить — только на **цифровые** линии энкодера A/B (и только если оставляете VCC энкодера 5 V). На IS и на UART не вешать.

---

## 7. Порядок сборки (чеклист)

1. Разметить зоны и крепёж.  
2. Впаять PBS-постель под Black Pill.  
3. Паять шины GND и 5V (флюс NC-559, ПОС-61).  
4. Впаять корпуса **XH** (J_PWR, J_UART, J_DRV×2, J_ENC×2), соблюдая ключ (выступ корпуса).  
5. Развести сигналы, прозвонить **до** драйверов.  
6. Стабилитроны на IS (если есть).  
7. Собрать 2 адаптера PH2.0 → XH-4 + силовые M+/M−.  
8. UBEC → J_PWR, проверить 5V.  
9. UART → ESP Expansion.  
10. J_DRV / J_ENC → проверка STOP/FORWARD как на стенде.

---

## 8. Что не кладём на макетку

- Корпуса BTS7960 и силовая батарея.  
- ESP32 Expansion Board.  
- Разъёмы **PH 2.0** как посадочные на плате (шаг 2.0 ≠ 2.54).

---

## 9. BOM из того, что уже есть (+ пробелы)

| Позиция | Что взять из набора | Кол-во | Статус |
| :--- | :--- | :---: | :--- |
| Постель MCU | PBS-40/20, отломки рядов | 2 ряда | есть |
| Ответная часть MCU | Dupont female | 2 ряда | есть |
| J_PWR | JST XH-2 или JST 2P (XH) | 1 | есть |
| J_UART | JST XH-3 или Dupont 1×3 | 1 | есть |
| J_DRV1 / J_DRV2 | JST XH-8 | 2 | есть |
| J_ENC1/2 | JST XH-4 | 2 | есть |
| Адаптер энкодера | JST PH 2.0 6P + XH-4 + провод 24AWG | 2 | есть |
| Жгуты сигналов | 22–24 AWG | по месту | есть |
| Сила моторов/батарея | 10–16 AWG | по месту | есть |
| Пайка | ПОС-61, NC-559-ASM, паяльник | — | есть |
| Стабилитрон 3.3 В на IS | BZX55C3V3 или аналог | 2 | **купить**, если нет |
| Стойки М3 | 30–50 мм из наличия (лучше 30–35 на макетку) | 4 | **есть** |
| Level shifter 5↔3.3 | из наличия | — | **не обязателен** (см. §6) |
| Макетка 60×80 2.54 | — | 1 | предполагается |

---

## 10. Следующий шаг

Сетка 22×27 с координатами каждого XH/PBS **или** сразу паять по зонам из §3 — на выбор.
