nvairob2/rc_tracked_vehicle/doc/Lidar/LdRobot_D500/D500.md

# D500

## Links
[D500 LiDAR Kit](https://www.waveshare.com/wiki/D500_LiDAR_Kit#Overview)
