nvairob2/rc_tracked_vehicle/schema/wire_connections.rtf

📍 Финальная и бесконфликтная карта портов BlackPill
Для двух бортов танка мы жестко закрепляем четыре независимых аппаратных таймера:
1 TIM3 — Генерация ШИМ для Борта 1
2 TIM1 — Генерация ШИМ для Борта 2
3 TIM5 — Аппаратный счетчик энкодера Борта 1
4 TIM4 — Аппаратный счетчик энкодера Борта 2

🛠️ БОРТ 1 (Левый)
• RPWM_1 (ШИМ Вперед) ➔ Пин PA6 (Таймер 3, Канал 1)
• LPWM_1 (ШИМ Назад) ➔ Пин PA7 (Таймер 3, Канал 2)
• EN_1 (Включение драйвера 1) ➔ Пин PA2 (Обычный GPIO)
• Энкодер 1, Фаза А (Провод 3 шлейфа) ➔ Пин PA0 (Таймер 5, Канал 1)
• Энкодер 1, Фаза B (Провод 4 шлейфа) ➔ Пин PA1 (Таймер 5, Канал 2)

🛠️ БОРТ 2 (Правый)
• RPWM_2 (ШИМ Вперед) ➔ Пин PA8 (Таймер 1, Канал 1)
• LPWM_2 (ШИМ Назад) ➔ Пин PA9 (Таймер 1, Канал 2)
• EN_2 (Включение драйвера 2) ➔ Пин PA3 (Обычный GPIO)
• Энкодер 2, Фаза А (Провод 3 шлейфа) ➔ Пин PB6 (Таймер 4, Канал 1) — Чистый пин без конфликтов!
• Энкодер 2, Фаза B (Провод 4 шлейфа) ➔ Пин PB7 (Таймер 4, Канал 2) — Чистый пин без конфликтов!

🔌 Линии питания (Общие для всей логики)
• Все контакты VCC энкодеров (Провод 2 шлейфов) и VCC логики драйверов ➔ К шине 5V BlackPill.
• Все контакты GND энкодеров (Провод 5 шлейфов) и GND логики драйверов ➔ К шине GND BlackPill.
