nvairob2/rc_tracked_vehicle/history/2026-10-31-webots-enu-orientation-fix.md

# Webots: ориентация тележки и препятствий (ENU)

## Проблема
Тележка «лежала» на боку (половина над полом / под полом), часть препятствий была ниже пола.

## Причина
Webots R2025a по умолчанию использует **ENU** (Z вверх). Модель и мир были собраны под классический **Y-up (NUE)** без явного `coordinateSystem "ENU"` и с размерами/смещениями под Y.

## Исправление
- `WorldInfo.coordinateSystem "ENU"`.
- `TrackedTank.proto`: Box `0.40 0.28 0.12` (длина/ширина/высота), колёса по ±Y, hinge `axis 0 1 0`, `translation` робота `0 0 0.05`.
- Препятствия: `translation.z = half_height`, столб с `rotation 1 0 0 π/2` (Cylinder вдоль Z).

## Проверка
Открыть `tank_room.wbt` заново (Reload World): тележка на полу, коробки и столб стоят на арене.

## Дополнение (колёса / лидар)
В R2022a+ ось `Cylinder` — локальный **Z** (FLU). Колёса: `rotation 1 0 0 π/2` (Z→Y). Лидар крутится вокруг локального Y → `rotation 1 0 0 -π/2`, чтобы Y смотрел вверх. Столб без лишнего поворота (Z уже вверх).
