nvairob2/rc_tracked_vehicle/ros2_ws/src/tank_sim/resource/tracked_tank.urdf

<?xml version="1.0"?>
<!-- URDF-плагин для webots_ros2_driver: моторы + Lidar D500. -->
<robot name="tracked_tank">
  <webots>
    <device reference="left_motor" type="RotationalMotor">
      <ros>
        <plugin type="webots_ros2_control::Ros2Control"/>
      </ros>
    </device>
  </webots>

  <!-- Упрощённый плагин дифференциала через DiffDrive -->
  <ros2_control name="WebotsControl" type="system">
    <hardware>
      <plugin>webots_ros2_control::Ros2ControlSystem</plugin>
    </hardware>
    <joint name="left_motor">
      <command_interface name="velocity"/>
      <state_interface name="position"/>
      <state_interface name="velocity"/>
    </joint>
    <joint name="right_motor">
      <command_interface name="velocity"/>
      <state_interface name="position"/>
      <state_interface name="velocity"/>
    </joint>
  </ros2_control>

  <link name="base_link"/>
  <link name="left_wheel"/>
  <link name="right_wheel"/>
  <joint name="left_motor" type="continuous">
    <parent link="base_link"/>
    <child link="left_wheel"/>
    <origin xyz="0 0.165 0" rpy="0 0 0"/>
    <axis xyz="0 1 0"/>
  </joint>
  <joint name="right_motor" type="continuous">
    <parent link="base_link"/>
    <child link="right_wheel"/>
    <origin xyz="0 -0.165 0" rpy="0 0 0"/>
    <axis xyz="0 1 0"/>
  </joint>
</robot>
