nvairob2/rc_tracked_vehicle/ros2_ws/src/tank_nav/config/mapper_params_online_async.yaml

# slam_toolbox: онлайн-картография. odom даёт scan_odom_node или Webots.
slam_toolbox:
  ros__parameters:
    use_sim_time: false
    odom_frame: odom
    map_frame: map
    base_frame: base_link
    scan_topic: /ldlidar_node/scan
    mode: mapping

    debug_logging: false
    throttle_scans: 1
    transform_publish_period: 0.02
    map_update_interval: 2.0
    resolution: 0.05
    max_laser_range: 12.0
    minimum_travel_distance: 0.05
    minimum_travel_heading: 0.05
    use_scan_matching: true
    use_scan_barycenter: true
    scan_buffer_size: 10
    scan_buffer_maximum_scan_distance: 10.0
    link_match_minimum_response_fine: 0.1
    link_scan_maximum_distance: 1.5
    loop_search_maximum_distance: 3.0
    do_loop_closing: true
    loop_match_minimum_chain_size: 10
    map_start_pose: [0.0, 0.0, 0.0]
