nvairob2/rc_tracked_vehicle/(commit log)

2026-07-17 Test with 2 motors
2026-07-17 Wiring diagram for pins
2026-07-18 Wiring diagram in MD
2026-07-19 Vehicle controller (ESP32) + motor controller (STM32)
2026-07-19 Wifi module + HTTP UI controller on ESP32
2026-07-25 Add encoder speed trim and BTS7960 current sense on STM32.
    Close the motor control loop with quadrature encoders and IS ADC
    feedback, and document the calibrated pin map for the breadboard stage.
2026-07-25 Add 60x80 mm protoboard signal-hub layout draft.
    Keep ESP32 on its expansion board; route STM32 logic, UART, encoders,
    and driver IS/PWM through terminal blocks on the solder protoboard.
2026-08-21 Add PS2 gamepad control and freeze the 60x80 protoboard pin map.
    Keep the Wi-Fi sketch unchanged; the new ESP32 firmware reads a DualShock-compatible receiver, sends signed move/turn including reverse, and the STM32 speed loop now trims at low encoder rates instead of falling back to open-loop.
    [PS2X_lib.cpp, motor_controller.ino, vehicle_controller_ps2.ino]
2026-08-21 Tune PS2 controls: latched stop, no stick reverse, hold-to-ramp, pivot turn.
    L2/R2 zero cruise speed on press, opposite stick only brakes to zero, L1/R1 ramp while held, and D-pad left/right spin in place.
    [vehicle_controller_ps2.ino]
2026-10-24 Add ROS2 stage 1 teleop over Wi-Fi: ESP32 Direct/ROS2, tank_teleop mixer, and micro-ROS bringup.
    Keep STM32 move,turn protocol unchanged; add watchdog, hold-to-drive web UI, and Start estop over the web overlay.
2026-10-24 Keep Direct-mode gamepad latency by spinning micro-ROS only in ROS2.
    Ping/UDP waits were blocking the ESP32 loop for hundreds of ms without an agent; document Arduino 3.x CDC and esp32s3 libmicroros setup.
2026-10-31 Add ROS2 stage 2 lidar Nav2 stack and Webots tank simulation.
    Wire D500 over USB on opi5 via ldlidar_node (/ldlidar_node/scan), with URDF, SLAM/Nav2 launches, and a Webots room world for offline checks.
2026-10-31 Fix Webots tank/obstacles for ENU and keep the adjusted camera.
    R2025a uses Z-up; align PROTO and room placements so the chassis and boxes sit on the floor.
